Souravgoswami/SPWM-UPS/README.md

### ⚠️⚠️ WIP

It may not work

Preview PCB:

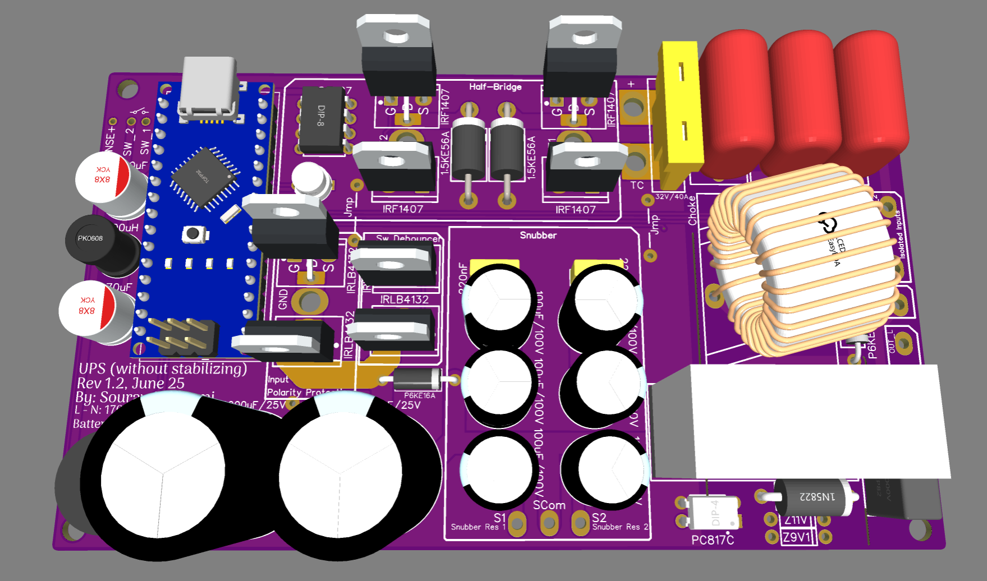
[picture p1: EasyEDA Only Schematics + PCB/top.png]
PCB_top

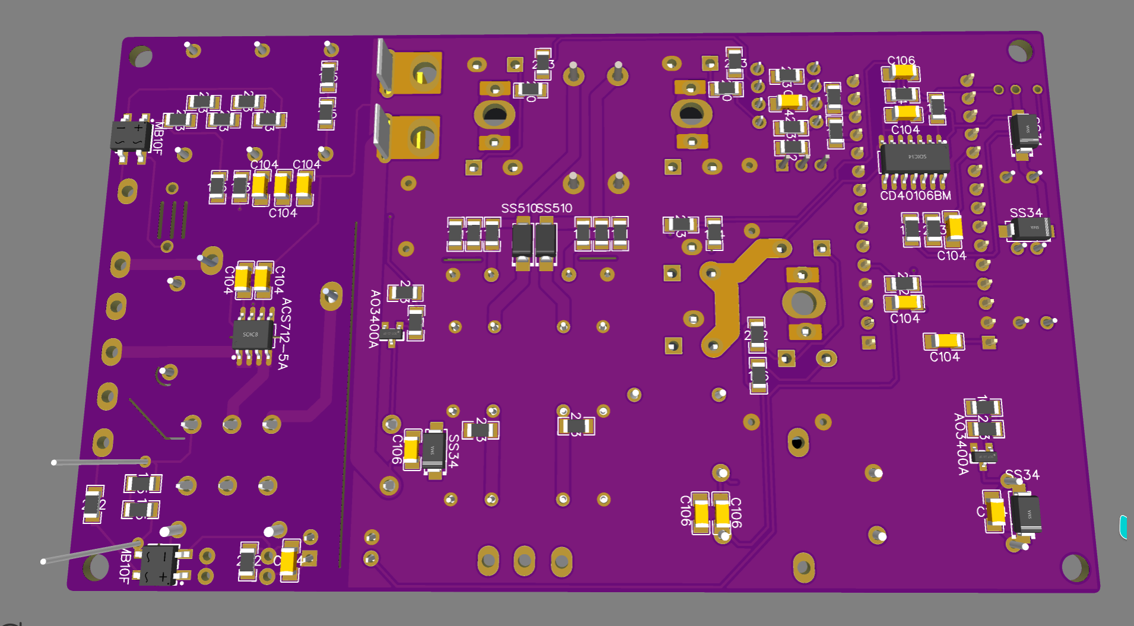
[picture p2: EasyEDA Only Schematics + PCB/bottom.png]
PCB_bottom


Schematic:
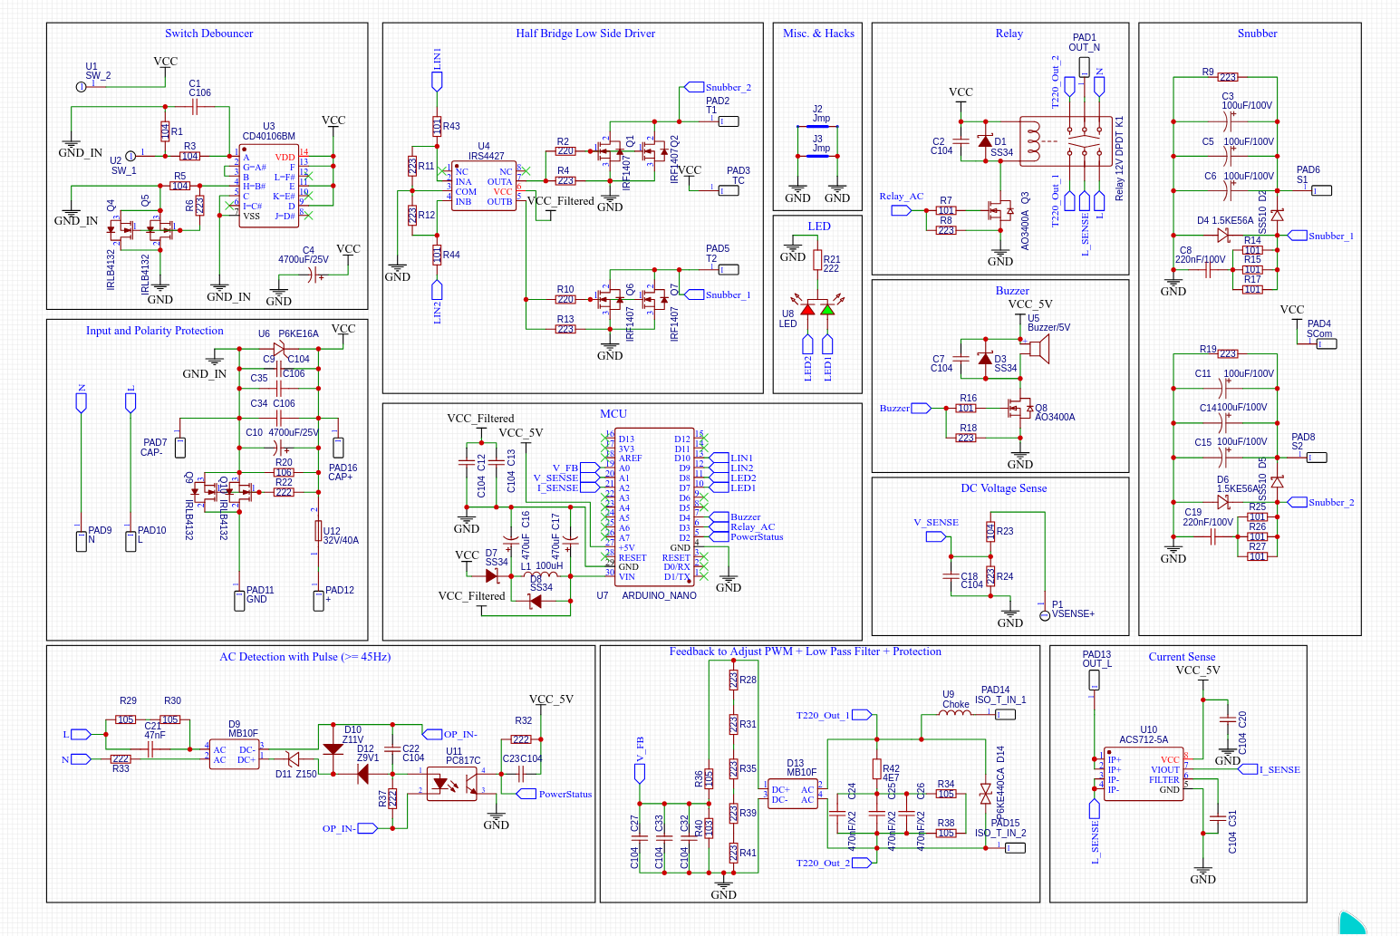
[picture p3: EasyEDA Only Schematics + PCB/schematic.png]
Schematic


SPWM:

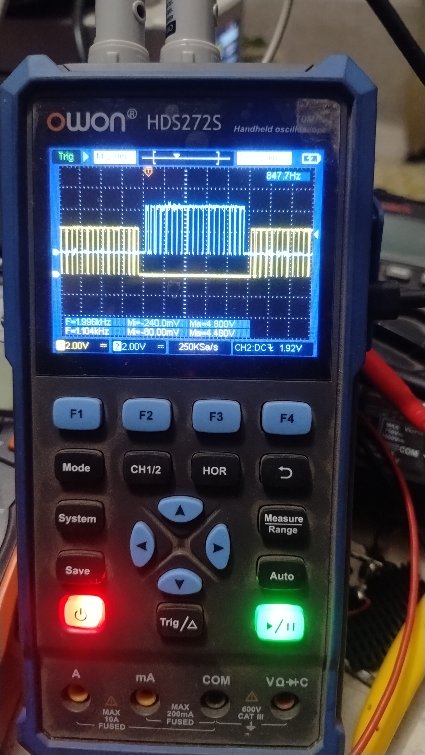
[picture p4: 2kHz SPWM.jpeg]
SPWM_2kHz_Waveform
