Souravgoswami/SPWM-UPS/(list of files, drawings)

Other design files:
EasyEDA Only Schematics + PCB/PCB_PCB_SPWM-UPS_REV_1.2_2025-06-01.json
EasyEDA Only Schematics + PCB/SCH_SPWM-UPS_2025-06-01.json
